mergenelk/mergen_smps/v0.0.1/Board/Technical/MergenSMPSBoardDesignTOP.png

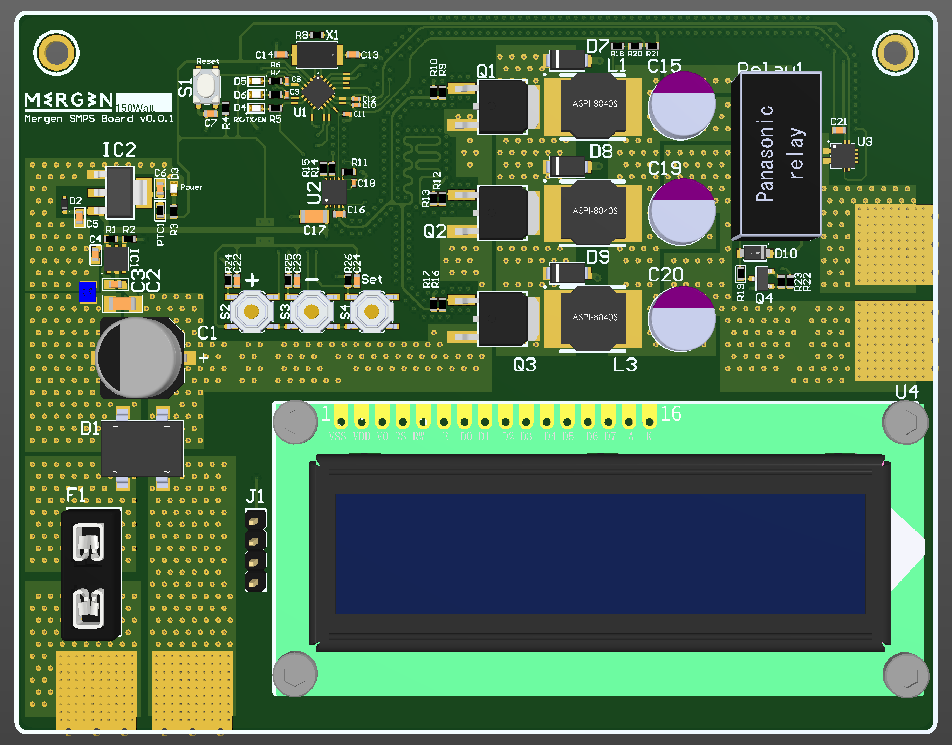
v0.0.1/Board/Technical/MergenSMPSBoardDesignTOP.png
