mergenelk/mergen_smps/v0.0.1/Board/MergenSMPSBoardBooklet.pdf

# Mergen SMPS

# Board v0.0.1

Design by Ekrem Turan Fırat

20240101

October 2024

## Contents:

Attention: This project is open source and still under development. The project is always dangerous because it involves grid electricity's transformation and control. The engineer is not responsible for any adverse situation that may occur.

Contact: ig:mergenelk

## 1) Purpose and Definition

This circuit is a student project and was made for learning purposes. The aim is to learn power electronics. The information given now is a sign of respect for everyone who helped me learn this information. Knowledge increases as it is shared.

This circuit aims to adjust the 36VAC (Mains electricity will be converted to this level with a transformer) input in the range of 0-30VDC. The project, which is currently 150 Watt, is a starting step for a 500 Watt keypad controlled power supply in the future.

## 2) Circuits and Design Values

a. POWER
- The power input will be 36VAC, after DC conversion the output is 50.904... This output will be controlled as 30 Volts.
- AC to DC conversion rates:
- AC Effective Value ➝ Vrms, Irms= Vmax/√2 or Vmax*0.707
- AC Peak Value ➝ Vmax = Vrms*√2 or Vrms*1.404
- Here, since our 36 Volt AC input will be converted to Vmax during DC conversion, the value of 36*1.404 is approximately 50.904, and 50 Volt output will be accepted for balance for losses and control purposes.
i. System Power Distribution
- The 50V input of the system will be divided into different voltage levels such as GATE Driver, Display and microcontroller etc.
- Texas Instruments UCC27282 will be used for GATE Driver. Since the recommended input voltage of the integrated circuit is 5.5V - 16V, it is necessary to convert the 50V input to this range with a linear converter.
- Conversion will be made with MAX5084 Linear Power Regulator Integrated Circuit
- Set Pin Resistance Formula ➝ R1=R2[Vout/Vset - 1]
- R1 = 5K R2= 1K values Vout = 7.5V
- 3.3V conversion will be made with AMS1117 derivatives for the microcontroller.

ii. SMPS Buck Converter Calculations and Values

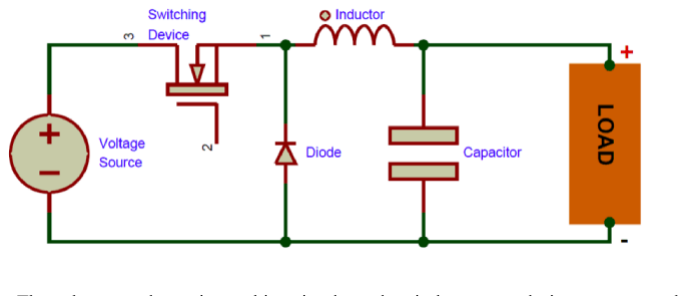
[picture p2: figure]

The values you determine at this point depend entirely on your design requests and the results that arise from them. For example, since I wanted a maximum output of 30 volts for a 50V input, a Maximum Duty Cycle of 75% was created at 80% efficiency.

- Efficiency ➝ 80% (Estimated)
- Maximum Input Voltage ➝ 51V
- Minimum Input Voltage ➝ 50V
- Output Voltage ➝ 0-30V
- Output Current 5A max
- Frequency ➝ 100000Hz = 100 kHz
- Maximum Duty Cycle ➝ 75% = 0.75
- Inductor Ripple Current ➝ ΔIL = 1.5A

ΔIL = Iout*0*3 = 5A*0.3

- Coil Inductance Value ➝ L = 80uh

L = Vout*(Vin -Vout)/( ΔIL*f*Vin) = 30*(20)/(1.5*100000*50)

- Capacitor Value ➝ C = 6.25 µF

C = ΔIL/(8*f*Vout) = 1.5/(8*100000*30)

- Diode Current ➝ ID = 1.25A

If = Iout*(1-D) = 5*(0.25)

b. Microcontroller

There is a STM32C011F6U6TR microcontroller on the board for switching.

There are test points on the PCB to be able to code the board and control the pins from outside.

The microcontroller operates at a frequency of 3.3V and 48 mHz and produces the switching frequency, and also performs voltage/current readings with the microcontroller circuit ACS712 and voltage dividers.aaaaaaaaaaaaaaaaaaaaaaaaaaaaaaaaaaaaaaaaaaaaaaaaa

Due to the lack of pins on the controller, the classic 16*2 LCD screen is used with I2C. Controls made via buttons are shown on the screen.aaaaaaaaaaaaaaaaaaaaaaaaaaaaaaaaaaaa

Current limiting is done by measuring the current digitally and controlling the line with a relay.

## 3) Schematics

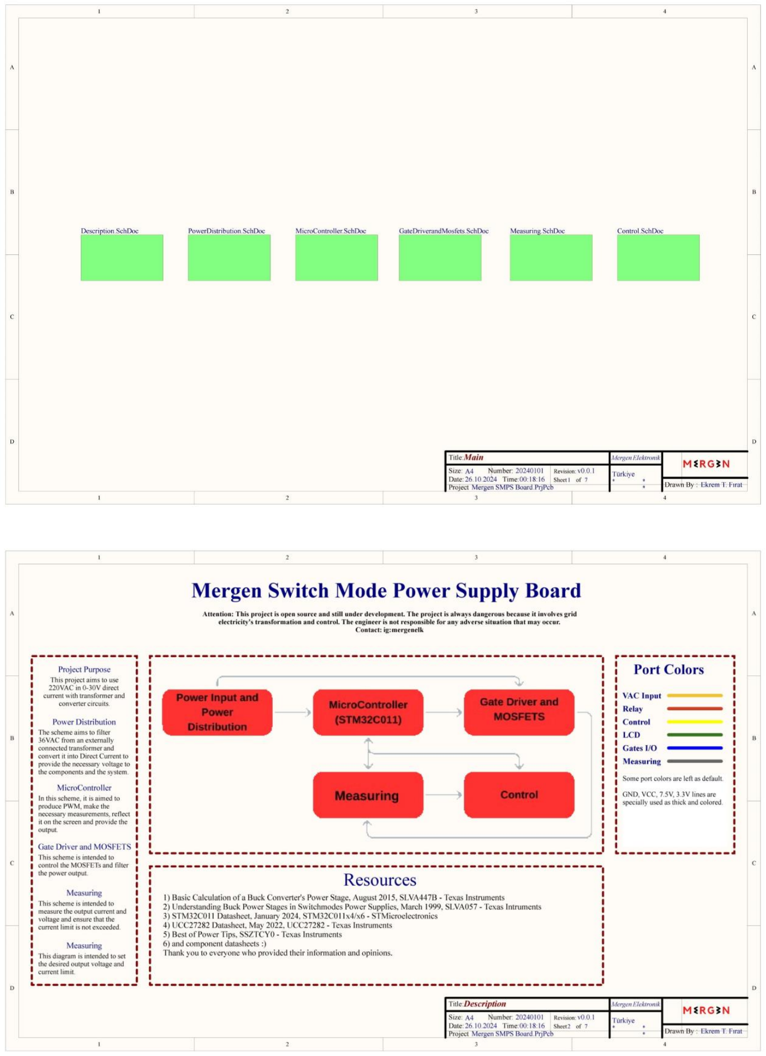
[picture p3: figure]
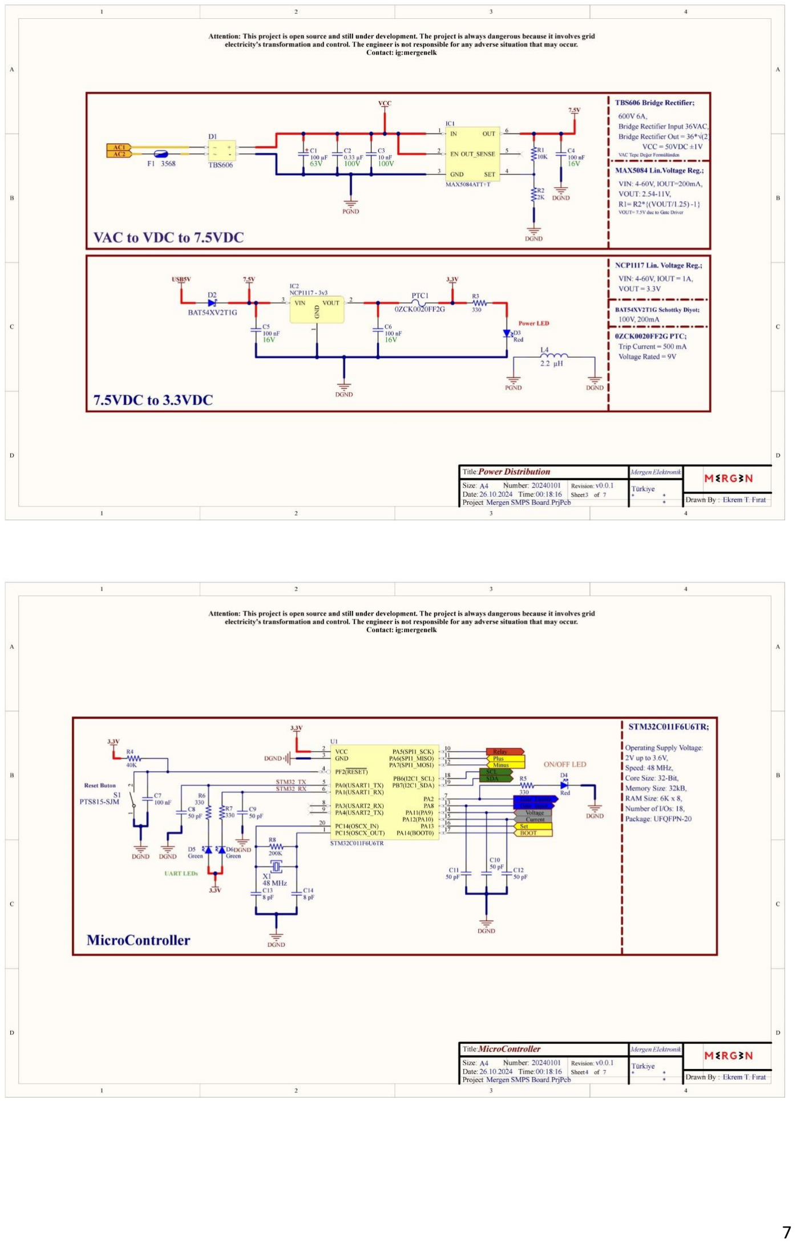
[picture p4: page 7]

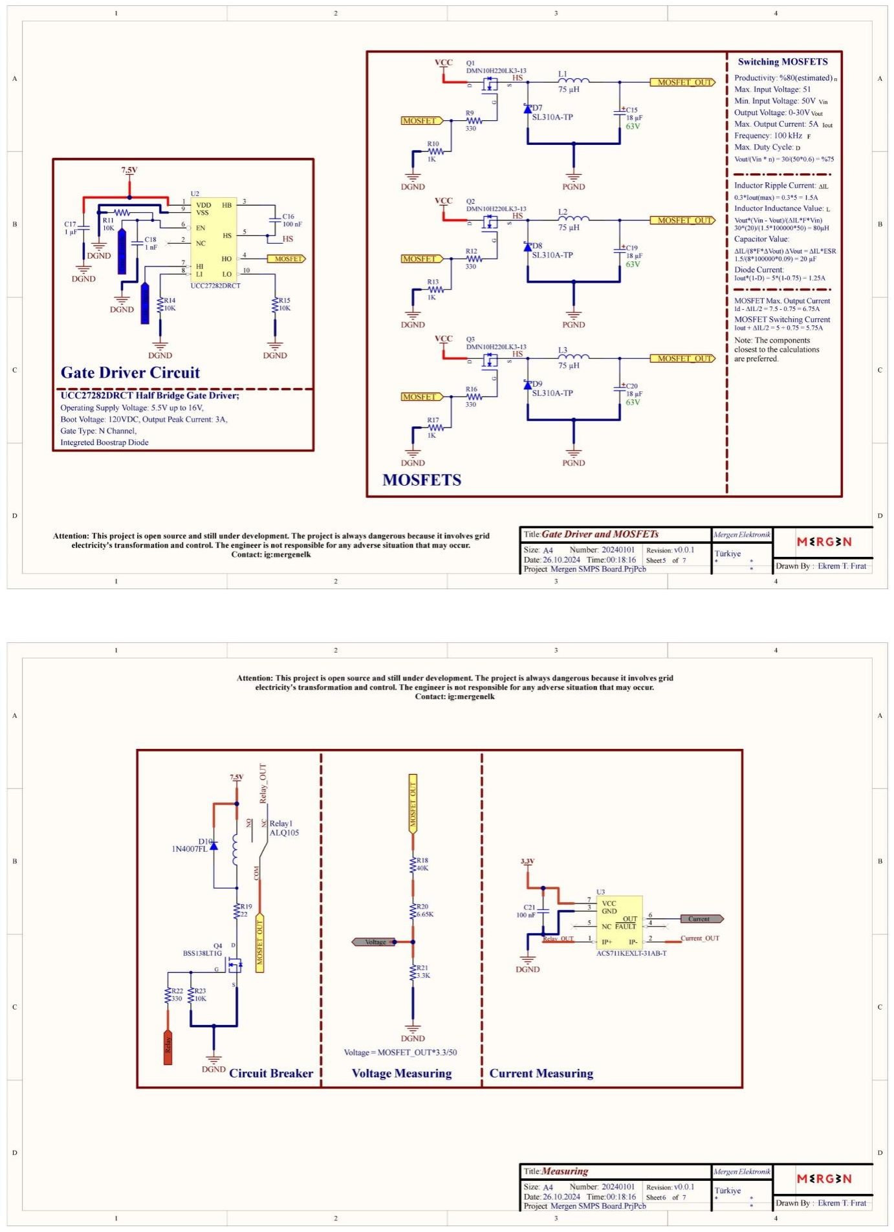
[picture p5: figure]
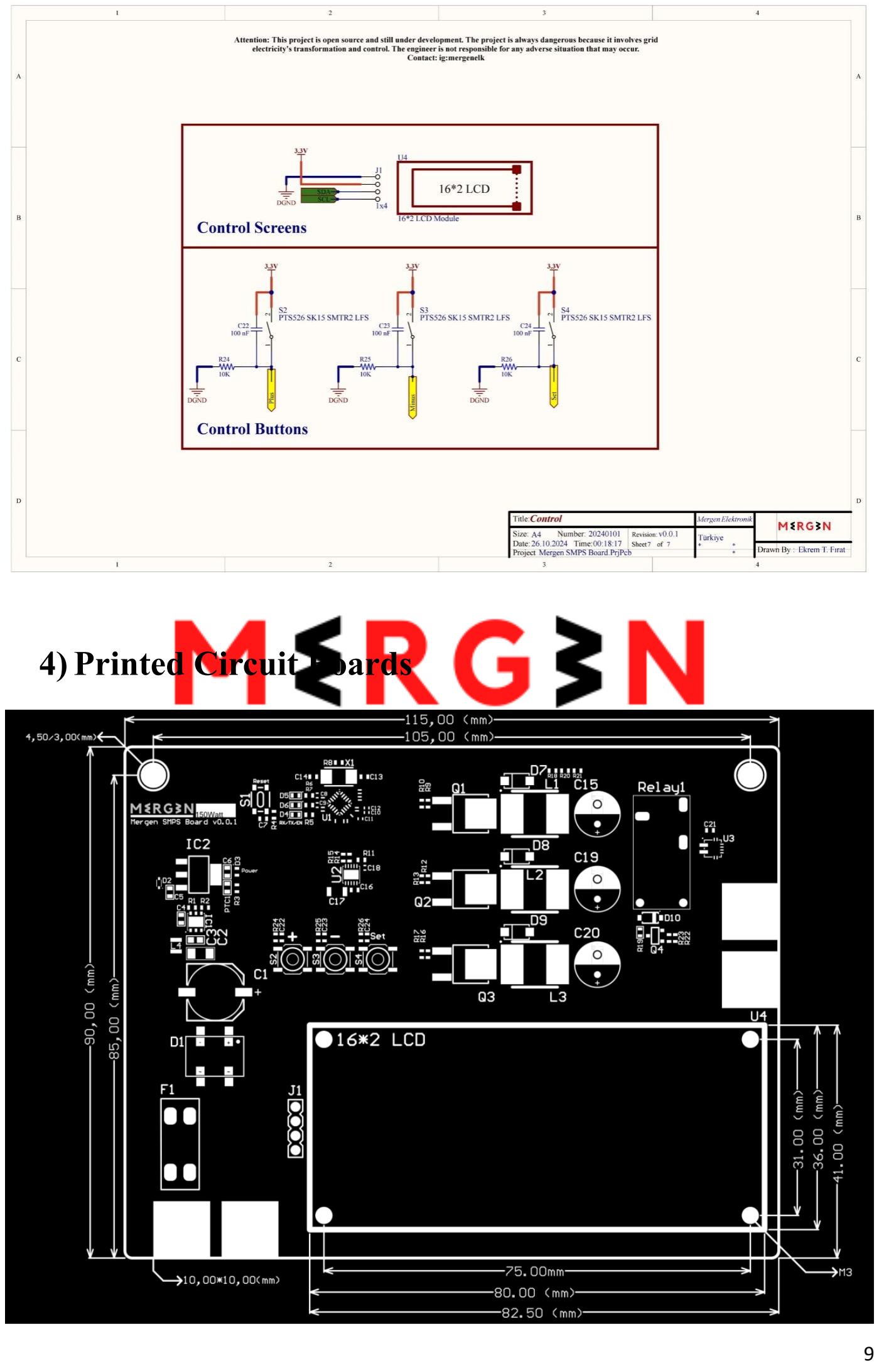
[picture p6: page 9]

## 4) Printed Circuit Boards

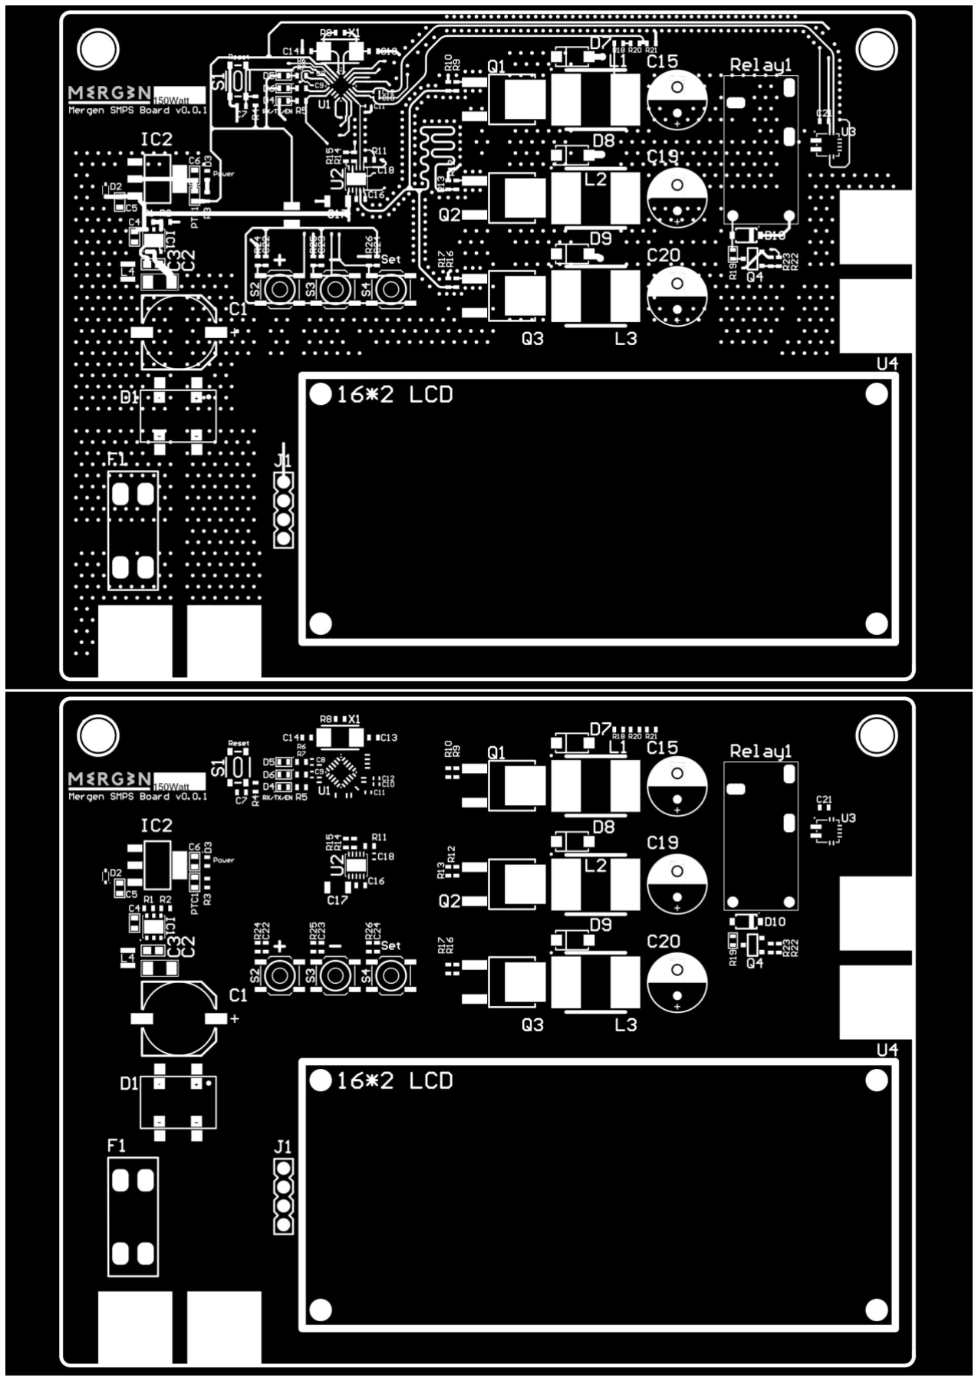
[picture p7: figure]
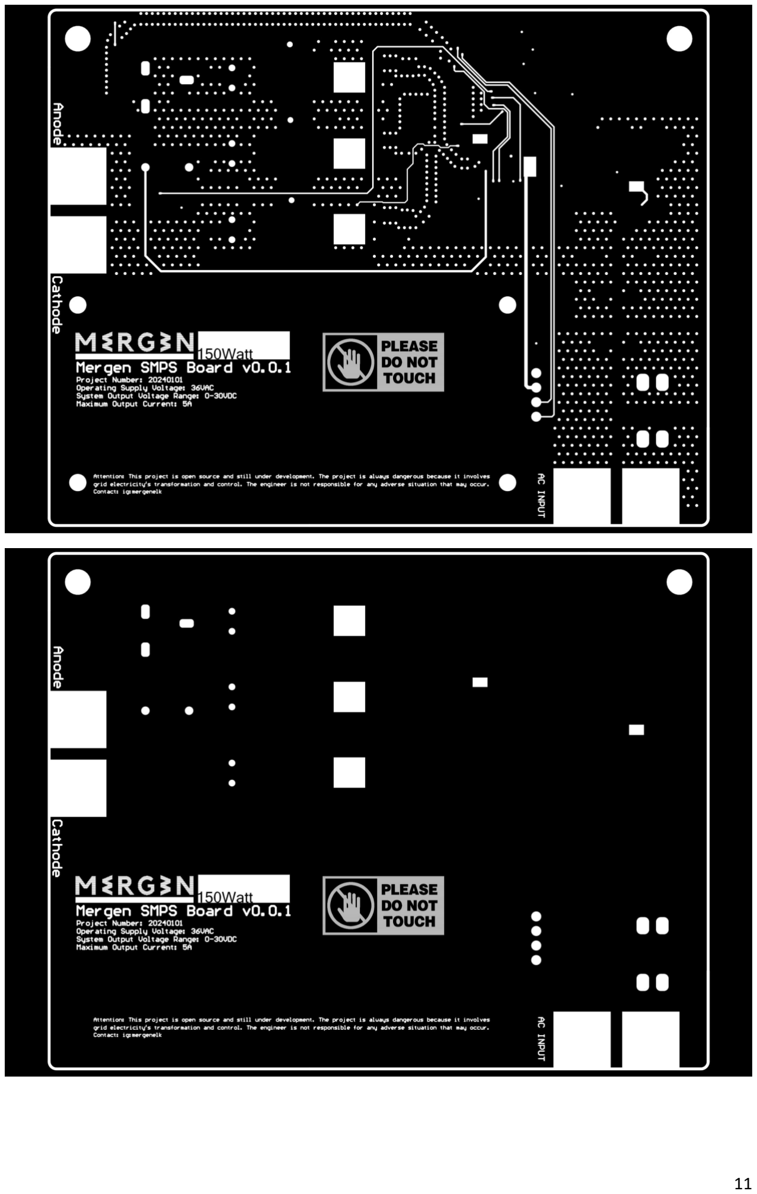
[picture p8: page 11]

## 5) Resources

- Basic Calculation of a Buck Converter's Power Stage, August 2015, SLVA447B - Texas Instruments
- Understanding Buck Power Stages in Switchmodes Power Supplies, March 1999, SLVA057 - Texas Intruments
- STM32C011 Datasheet, January 2024, STM32C011x4/x6 - STMicroelectronics
- UCC27282 Datasheet, May 2022, UCC27282 - Texas Instruments
- Best of Power Tips, SSZTCY0 - Texas Instruments
- and component datasheets :)
- Thank you to everyone who provided their information and opinions.

Embedded software is under development.

Github.com/mergenelk

Attention: This project is open source and still under development. The project is always dangerous because it involves grid electricity's transformation and control. The engineer is not responsible for any adverse situation that may occur.

Contact: ig:mergenelk
