mergenelk/mergen_smps/v0.0.1/Board/Technical/MergenSMPSBoardDesignBottom.png

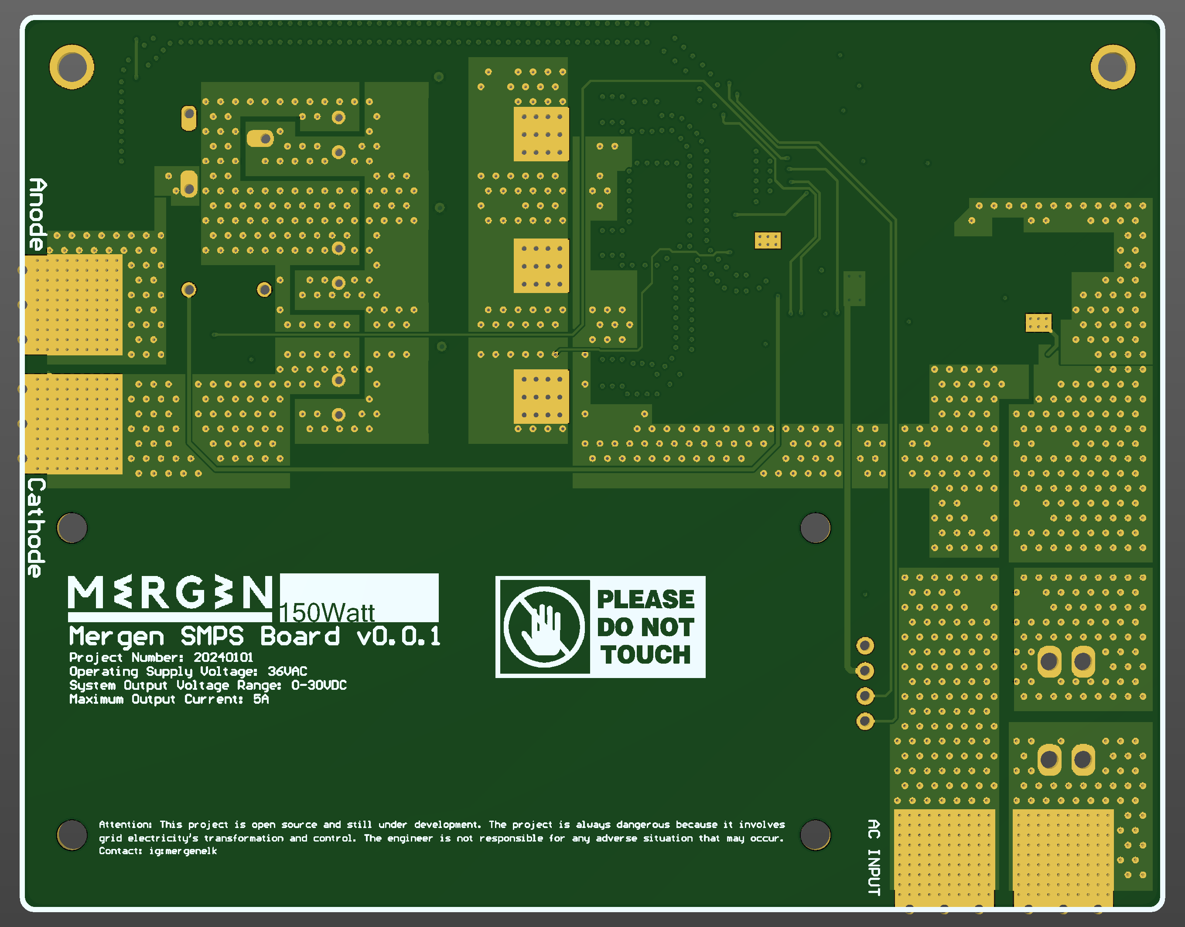
v0.0.1/Board/Technical/MergenSMPSBoardDesignBottom.png
