mergenelk/mergen_smps/v0.0.1/Board/BOM/Mergen SMPS Board.xlsx

 | Bill of Materials |  |  | Bill of Materials for Project [Mergen SMPS Board.PrjPcb] (No PCB Document Selected)
 | Basic Material List |  |  | Mergen SMPS Board.PrjPcb
 | <Parameter Version not found> |  |  | Mergen SMPS Board.PrjPcb
 | Ekrem Turan Fırat |  |  | Ekrem T. Fırat
 | Report Date: |  | 26.10.2024 | 00:48
 | Print Date: |  | 2024-10-26 | 0:48:49
# | Designator | Comment | Package | Mounting Type | Manufacturer | Manufacturer Number | Quantity
1 | C1 | 100 µF | 10x10.5mm | Surface Mount | Nichicon | UUX1J101MNL1GS | 1
2 | C2 | 0.33 µF | 1206(3216 Metric) | Surface Mount | TDK Corporation | C3216X7R2A334K130AA | 1
3 | C3 | 10 nF | 0603(1608 Metric) | Surface Mount | Murata Electronics | GCM188R72A103KA37D | 1
4 | C4, C5, C6 | 100 nF | 0603(1608) | Surface Mount | Samsung Electro-Mechanics | CL10B104KO8NNNC | 3
5 | C7, C16, C21, C22, C23, C24 | 100 nF | 0603(1608), 0603(1608 Metric) | Surface Mount | Samsung Electro-Mechanics | CL10B104KO8NNNC, CL10B104KC8NNNC | 6
6 | C8, C9, C10, C11, C12 | 50 pF | 0603(1608) | Surface Mount | YAGEO | CC0402JRNPO9BN500 | 5
7 | C13, C14 | 8 pF | 0603(1608) | Surface Mount | YAGEO | CC0603DRNPO9BN8R0 | 2
8 | C15, C19, C20 | 18 µF | 8x7mm | Through Hole | Panasonic Electronic Components | 100SXE6R8M | 3
9 | C17 | 1 µF | 1206(3216 Metric) | Surface Mount | Samsung Electro-Mechanics | CL31B105KCHNNNE | 1
10 | C18 | 1 nF | 0402(1005 Metric) | Surface Mount | Murata Electronics | GRM1555C1H102JA01D | 1
11 | D1 | TBS606 | TBS606 | Surface Mount | Taiwan Semiconductor Corporation | TBS606 | 1
12 | D2 | BAT54XV2T1G | SOD-523 | Surface Mount | onsemi | BAT54XV2T1G | 1
13 | D3 | Red | 0603(1608) | Surface Mount | Würth Elektronik | 150060RS75000 | 1
14 | D4 | Red | 0603(1608) | Surface Mount | Würth Elektronik | 150060RS75000 | 1
15 | D5, D6 | Green | 0603(1608) | Surface Mount | Würth Elektronik | 150060GS75000 | 2
16 | D7, D8, D9 | SL310A-TP | DO-214AC(SMA) | Surface Mount | Micro Commercial Co | SL310A-TP | 3
17 | D10 | 1N4007FL | SOD-123F | Surface Mount | SMC Diode Solutions | 1N4007FL | 1
18 | F1 | 3568 | 3568 | THT | Keystone Electronics | 3568 | 1
19 | IC1 | MAX5084ATT+T | 6-TDFN | Surface Mount | Analog Devices Inc./Maxim Integrated | MAX5084ATT+T | 1
20 | IC2 | NCP1117 - 3v3 | SOT-223 | Surface Mount | onsemi | NCP1117ST33T3G | 1
21 | J1 | 1x4 |  |  |  |  | 1
22 | L1, L2, L3 | 75 µH | 8x8x4mm Shielded | Surface Mount | Abracon LLC | ASPI-8040S-750M-T | 3
23 | L4 | 2.2 µH | 1008 (2520 Metric) | Surface Mount | Samsung Electro-Mechanics | CIGT252008LM2R2MNE | 1
24 | PTC1 | 0ZCK0020FF2G | 0805(2012) | Surface Mount | Bel Fuse Inc. | 0ZCK0020FF2G | 1
25 | Q1, Q2, Q3 | DMN10H220LK3-13 | TO-252-3 DPAK | Surface Mount | Diodes Incorporated | DMN10H220LK3-13 | 3
26 | Q4 | BSS138LT1G | SOT-23 | Surface Mount | onsemi | BSS138LT1G | 1
27 | R1, R11, R14, R15, R23, R24, R25, R26 | 10K | 0603(1608) | Surface Mount | Stackpole Electronics Inc | RMCF0603JT10K0 | 8
28 | R2 | 2K | 0603(1608) | Surface Mount | Panasonic Electronic Components | ERJ-3EKF2001V | 1
29 | R3, R5, R6, R7, R9, R12, R16, R22 | 330 | 0603(1608) | Surface Mount | Stackpole Electronics Inc | RMCF0603JT330R | 8
30 | R4, R18 | 40K | 0603(1608) | Surface Mount | YAGEO | RT0603BRD0740KL | 2
31 | R8 | 200K | 0603(1608) | Surface Mount | Stackpole Electronics Inc | RMCF0603FT200K | 1
32 | R10, R13, R17 | 1K | 0603(1608) | Surface Mount | Stackpole Electronics Inc | RMCF0603JT1K00 | 3
33 | R19 | 22 | 0603(1608) | Surface Mount | TE Connectivity Passive Product | CRGCQ0603J22R | 1
34 | R20 | 6.65K | 0603(1608) | Surface Mount | YAGEO | RC0603FR-076K65L | 1
35 | R21 | 3.3K | 0603(1608) | Surface Mount | YAGEO | RC0603FR-073K3L | 1
36 | Relay1 | ALQ105 | ALQ105 | THT | Panasonic Electric Works | ALQ105 | 1
37 | S1 | PTS815-SJM | PTS815 | Surface Mount | C&K | PTS815 SJM 250 SMTR LFS | 1
38 | S2, S3, S4 | PTS526 SK15 SMTR2 LFS | PTS526 | Surface Mount | C&K | PTS526 SK15 SMTR2 LFS | 3
39 | U1 | STM32C011F6U6TR | UFQFPN-20 | Surface Mount | STMicroelectronics | STM32C011F6U6TR | 1
40 | U2 | UCC27282DRCT | 10-VSON 3x3 | Surface Mount | Texas Instruments | UCC27282DRCT | 1
41 | U3 | ACS711KEXLT-31AB-T | ACS711KEXLT-31AB-T | Surface Mount | Allegro MicroSystems | ACS711KEXLT-31AB-T | 1
42 | U4 | 16*2 LCD Module |  |  |  |  | 1
43 | X1 | 48 MHz | 2-SMD | Surface Mount | NDK America, Inc. | LNCD1-48M | 1
Approved |  |  |  | Notes |  |  | 83
