mergenelk/mergen_smps/v0.0.1/Board/Technical/MergenSMPSBoardDesignWithOutComponents.png

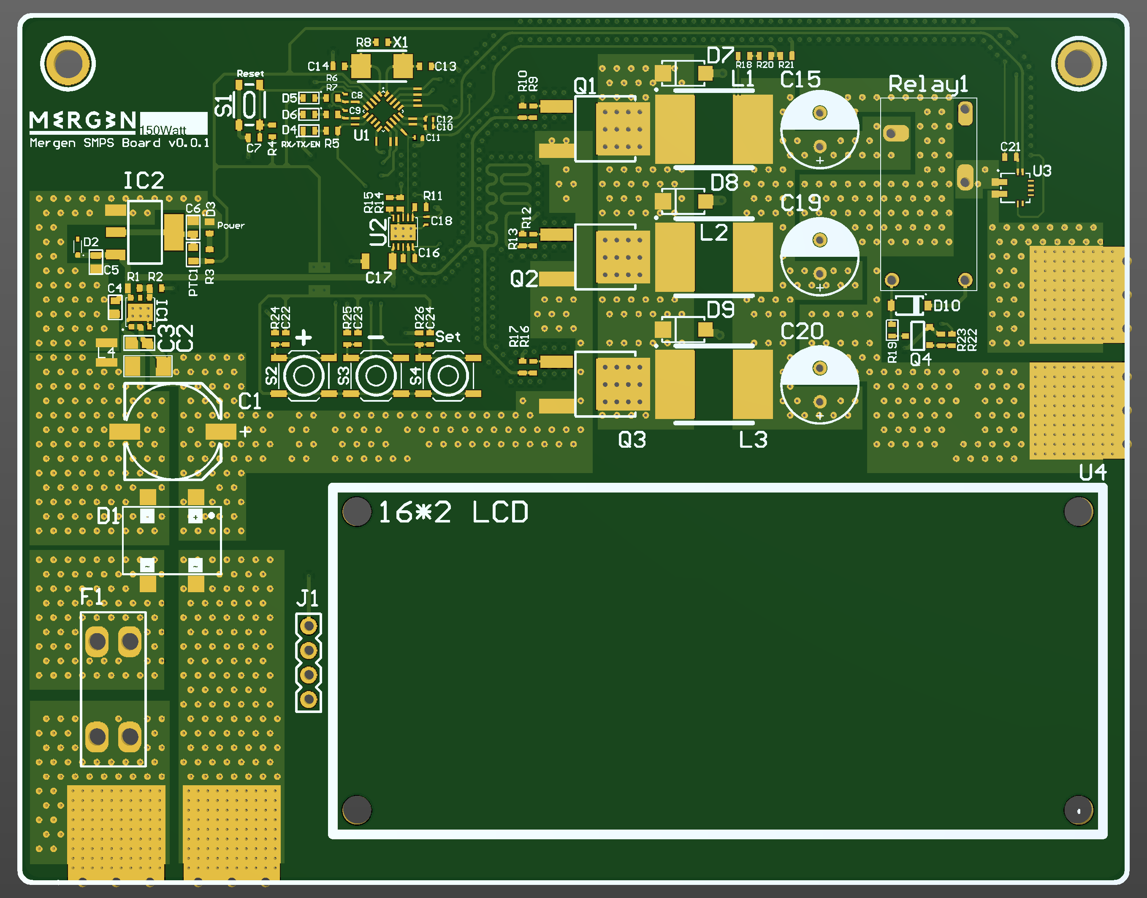
v0.0.1/Board/Technical/MergenSMPSBoardDesignWithOutComponents.png
