mergenelk/mergen_smps/v0.0.1/Board/Technical/MergenSMPSBoardDesignBottomOverlaySide.pdf

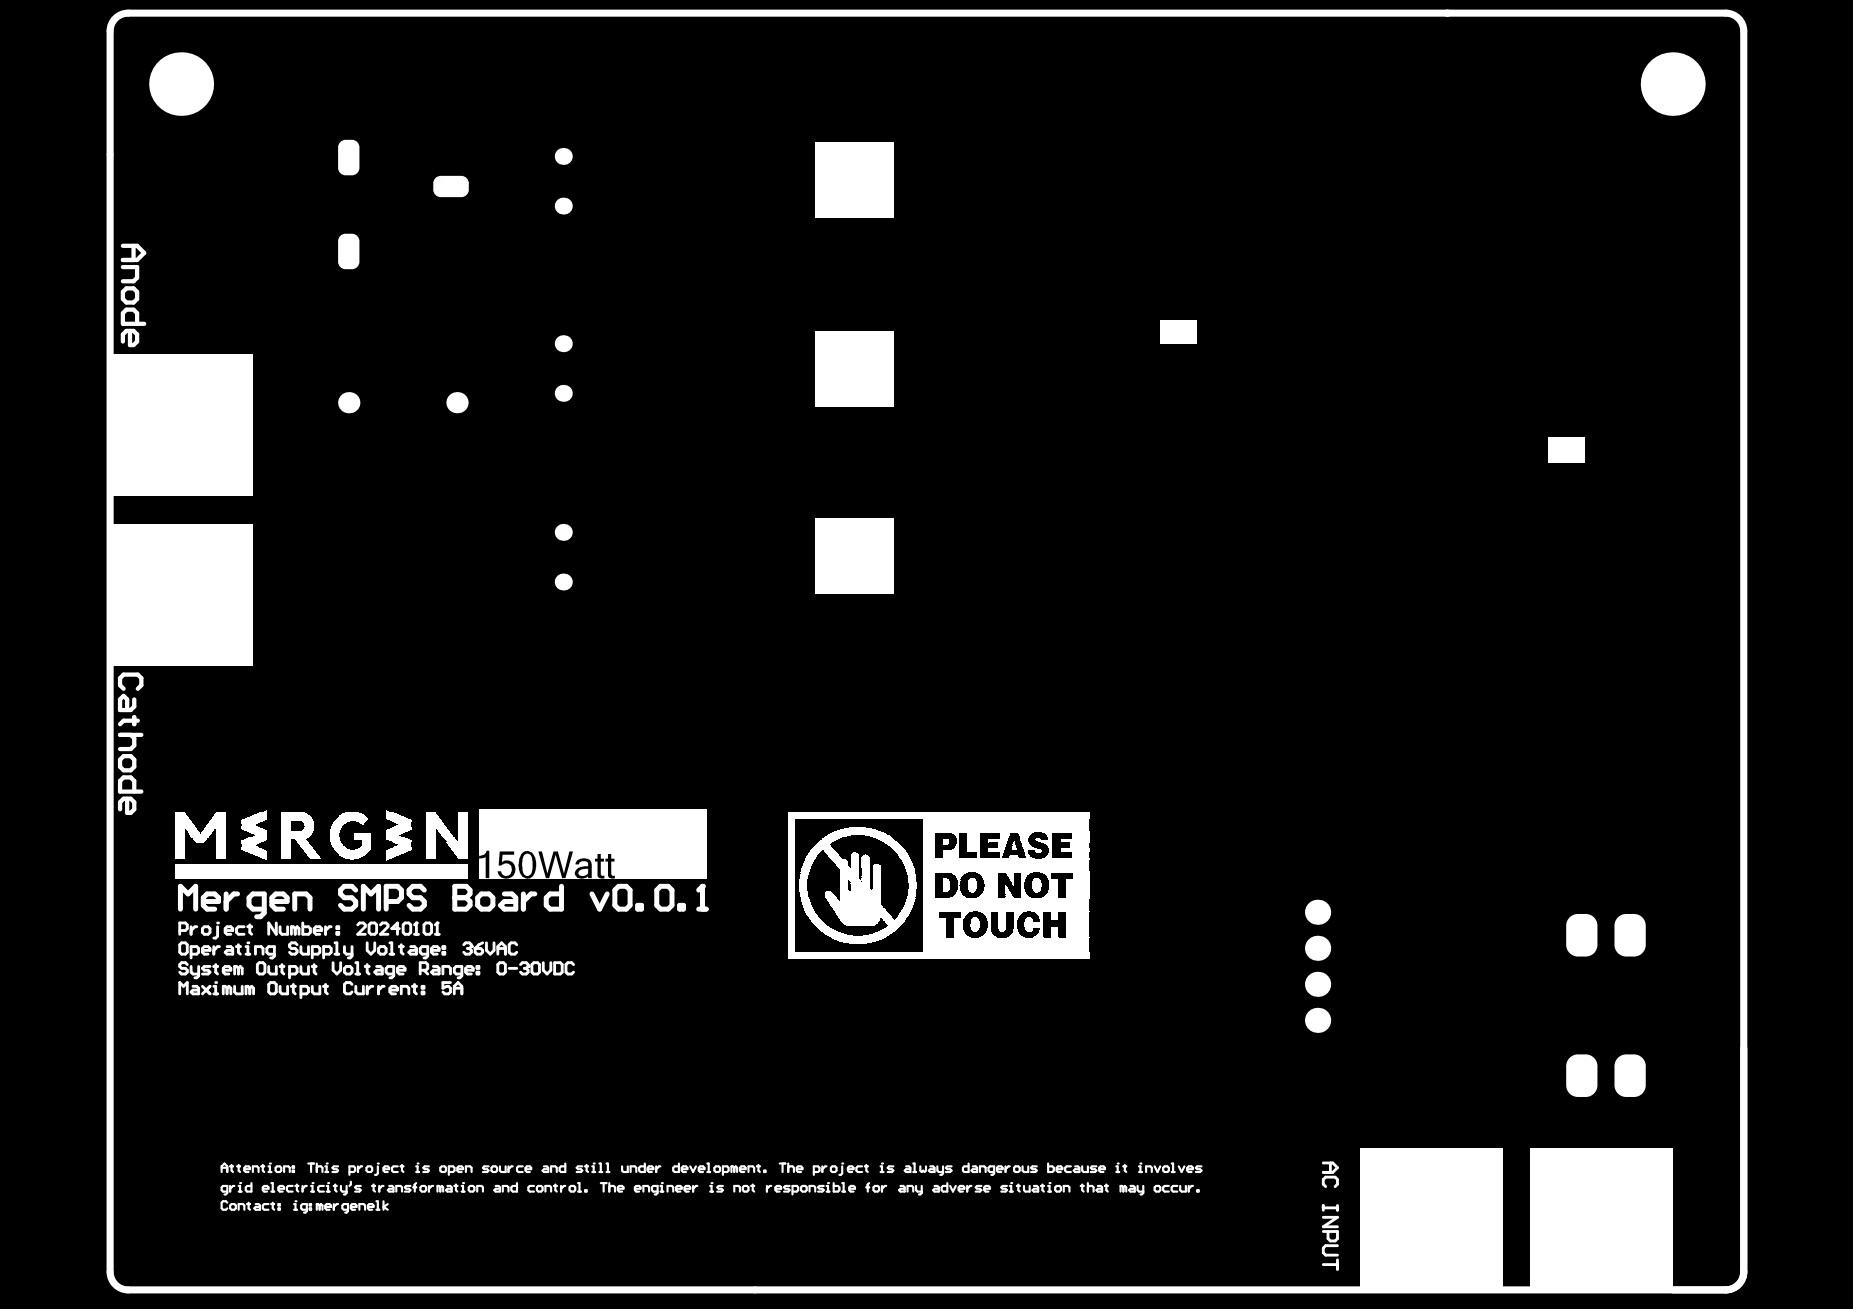
[picture p11: page 1]
