mergenelk/mergen_smps/v0.0.1/Board/Technical/MergenSMPSBoardDesignBottomSide.pdf

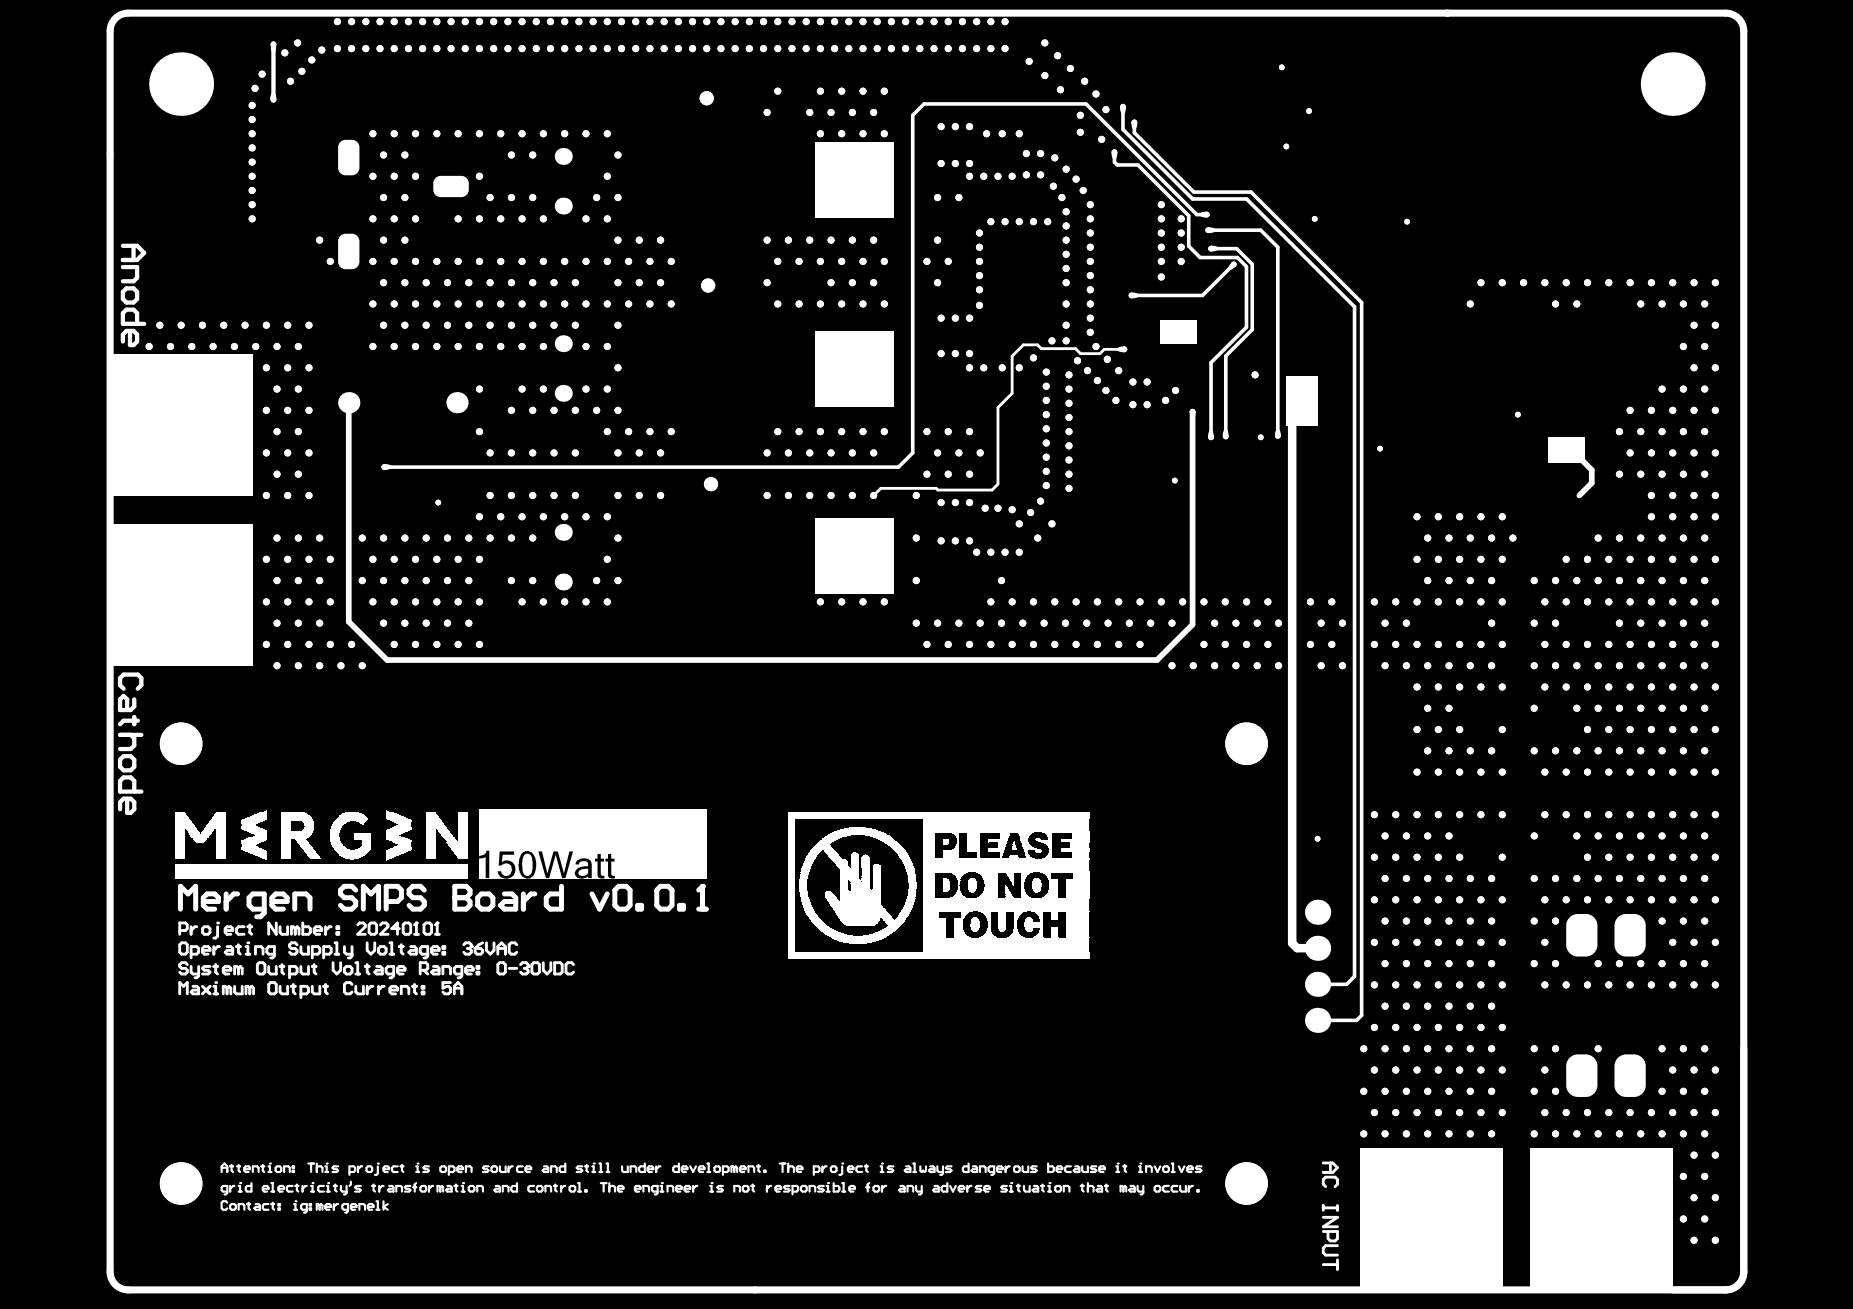
[picture p12: page 1]
