mergenelk/mergen_smps/v0.0.1/Board/Technical/MergenSMPSBoardDesignTopDimensionSide.pdf

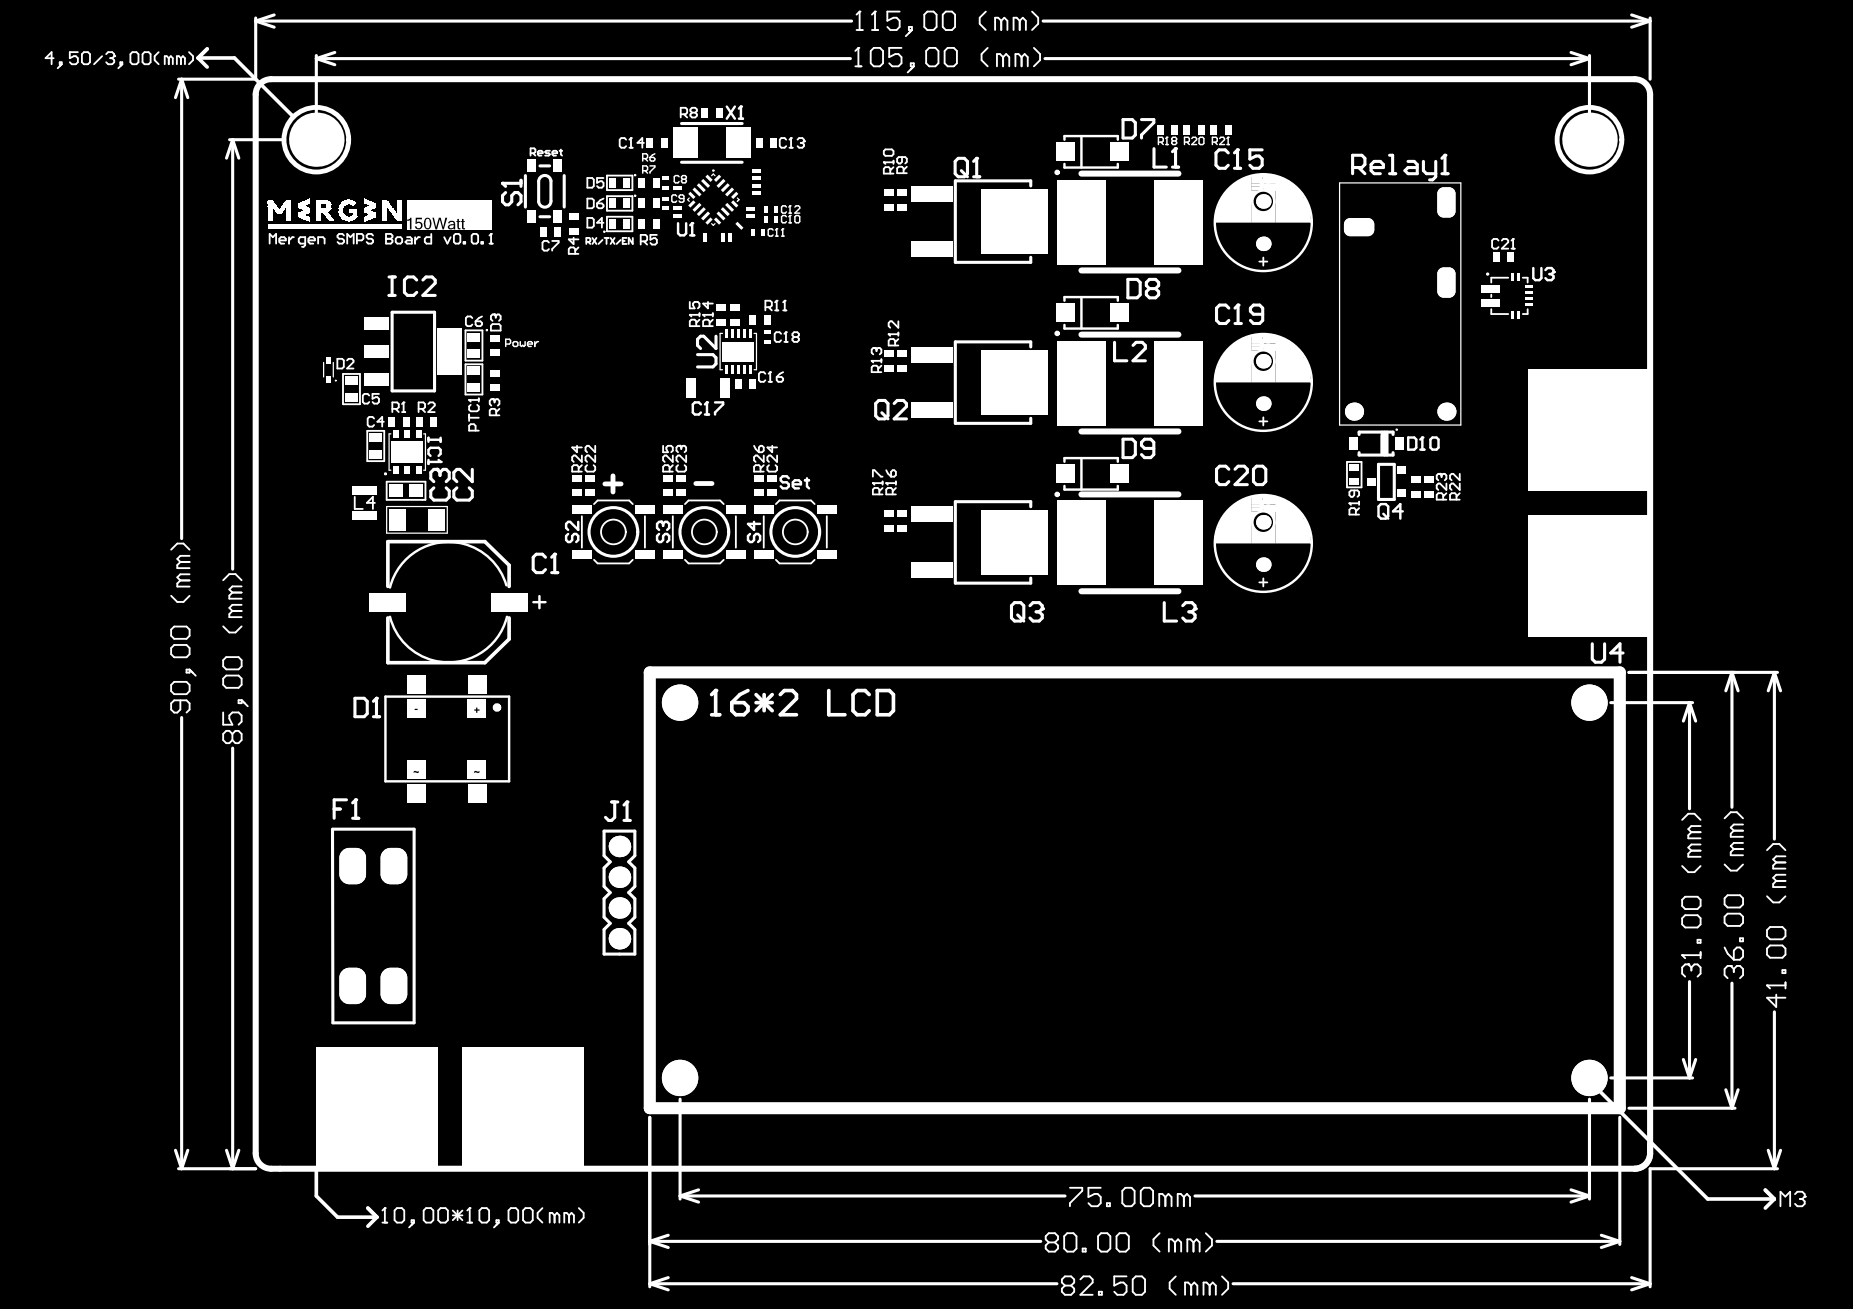
[picture p13: page 1]
