mergenelk/mergen_smps/v0.0.1/Board/Technical/MergenSMPSBoardDesignTopOverlaySide.pdf

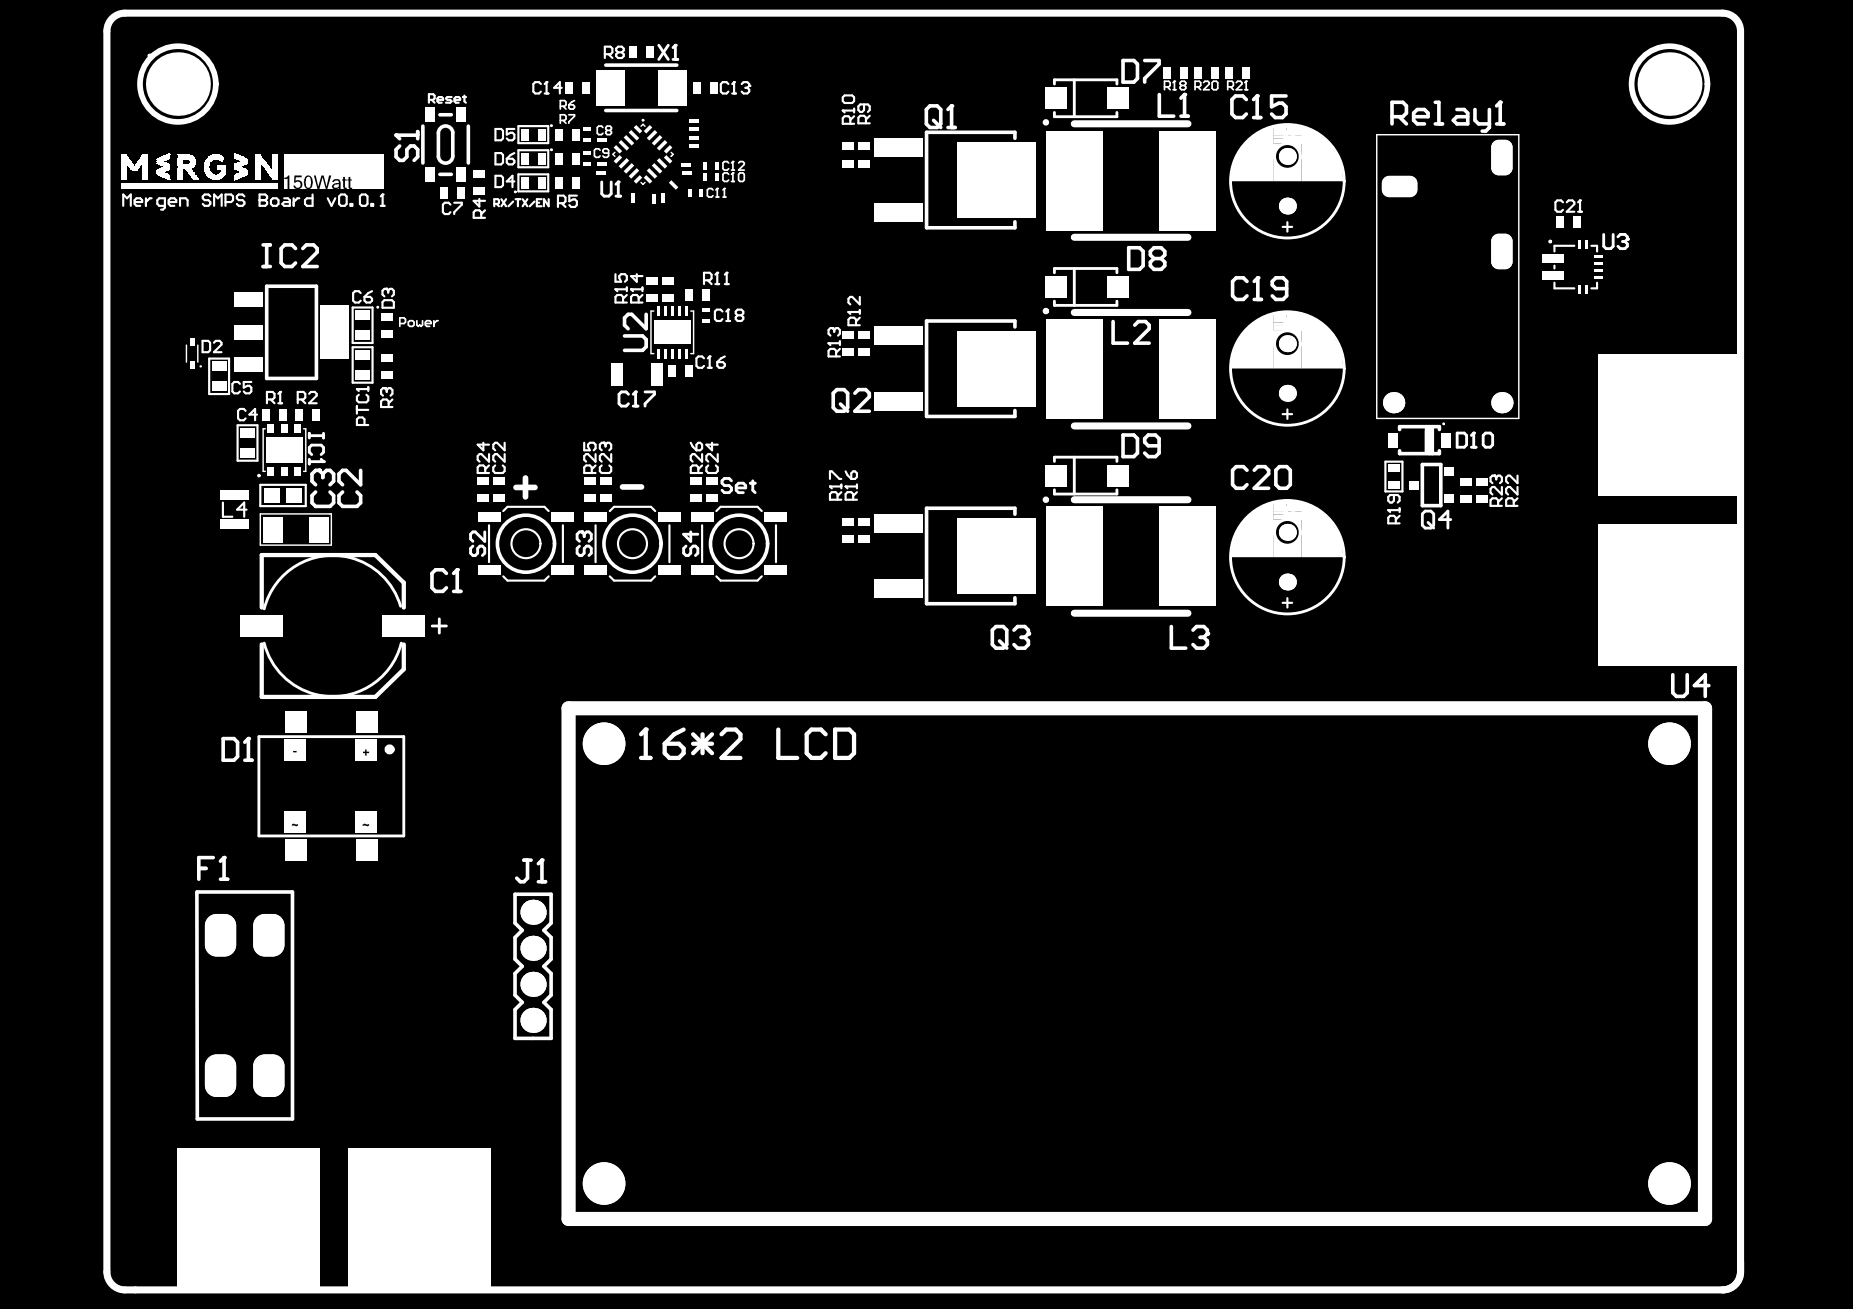
[picture p14: page 1]
