mergenelk/mergen_smps/v0.0.1/Board/Technical/MergenSMPSBoardDesignTopSide.pdf

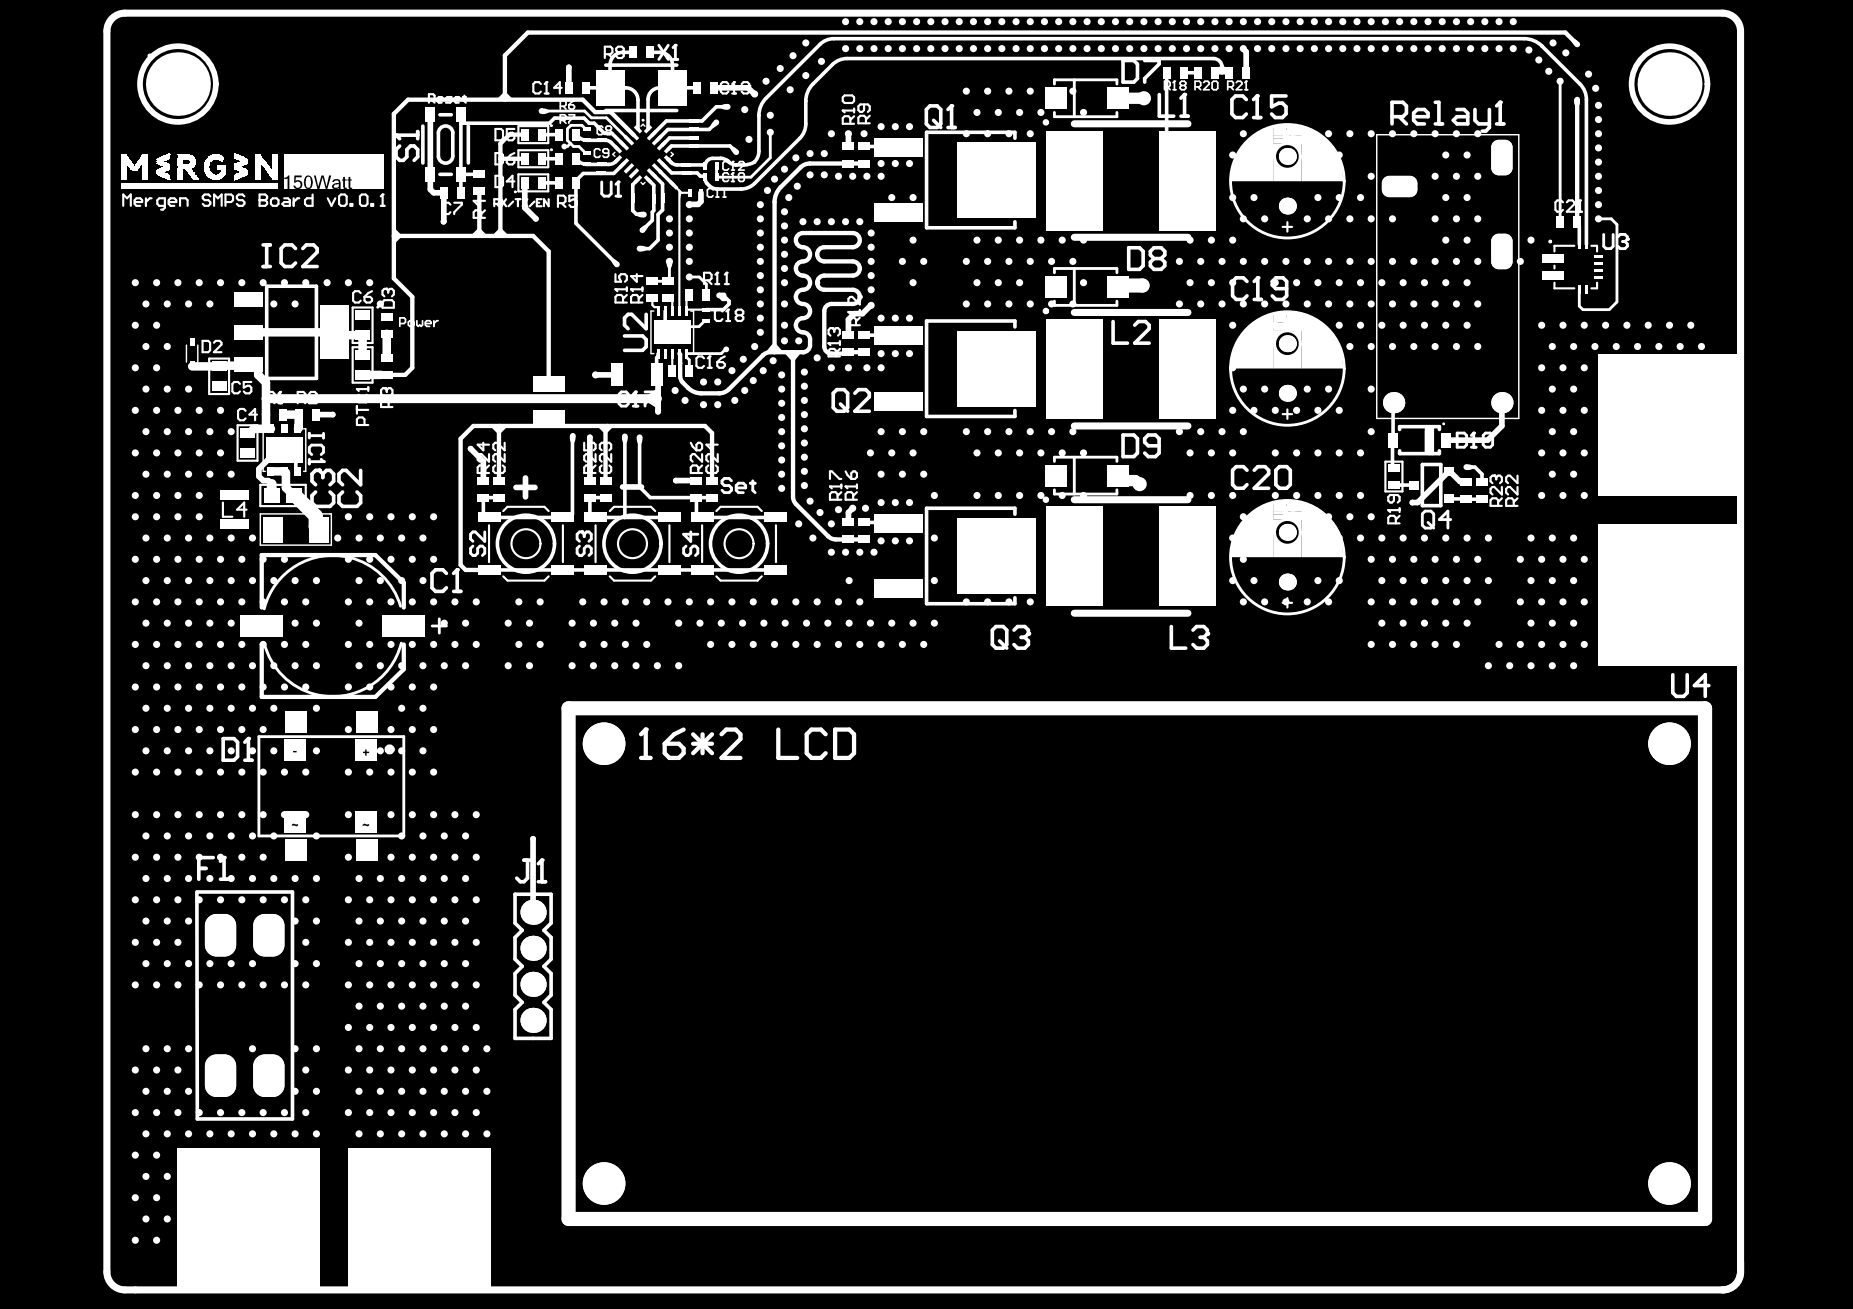
[picture p15: page 1]
