mergenelk/mergen_smps/(list of files, drawings)

Other design files:
v0.0.1/Board/SchematicandPCB/Control.SchDoc
v0.0.1/Board/SchematicandPCB/Description.SchDoc
v0.0.1/Board/SchematicandPCB/GateDriverandMosfets.SchDoc
v0.0.1/Board/SchematicandPCB/Main.SchDoc
v0.0.1/Board/SchematicandPCB/Measuring.SchDoc
v0.0.1/Board/SchematicandPCB/Mergen SMPS Board.PrjPcb
v0.0.1/Board/SchematicandPCB/MicroController.SchDoc
v0.0.1/Board/SchematicandPCB/PowerDistribution.SchDoc
